MissouriMRDT/ScienceHeaterElement_Breakout/README.md

# ScienceHeater_2024
Files for Science Heater
