MissouriMRDT/ScienceHeaterElement_Breakout/Hardware/ScienceHeaterElement_2023.kicad_pcb

## KiCad design Hardware/ScienceHeaterElement_2023.kicad_pcb (2023-11-14)

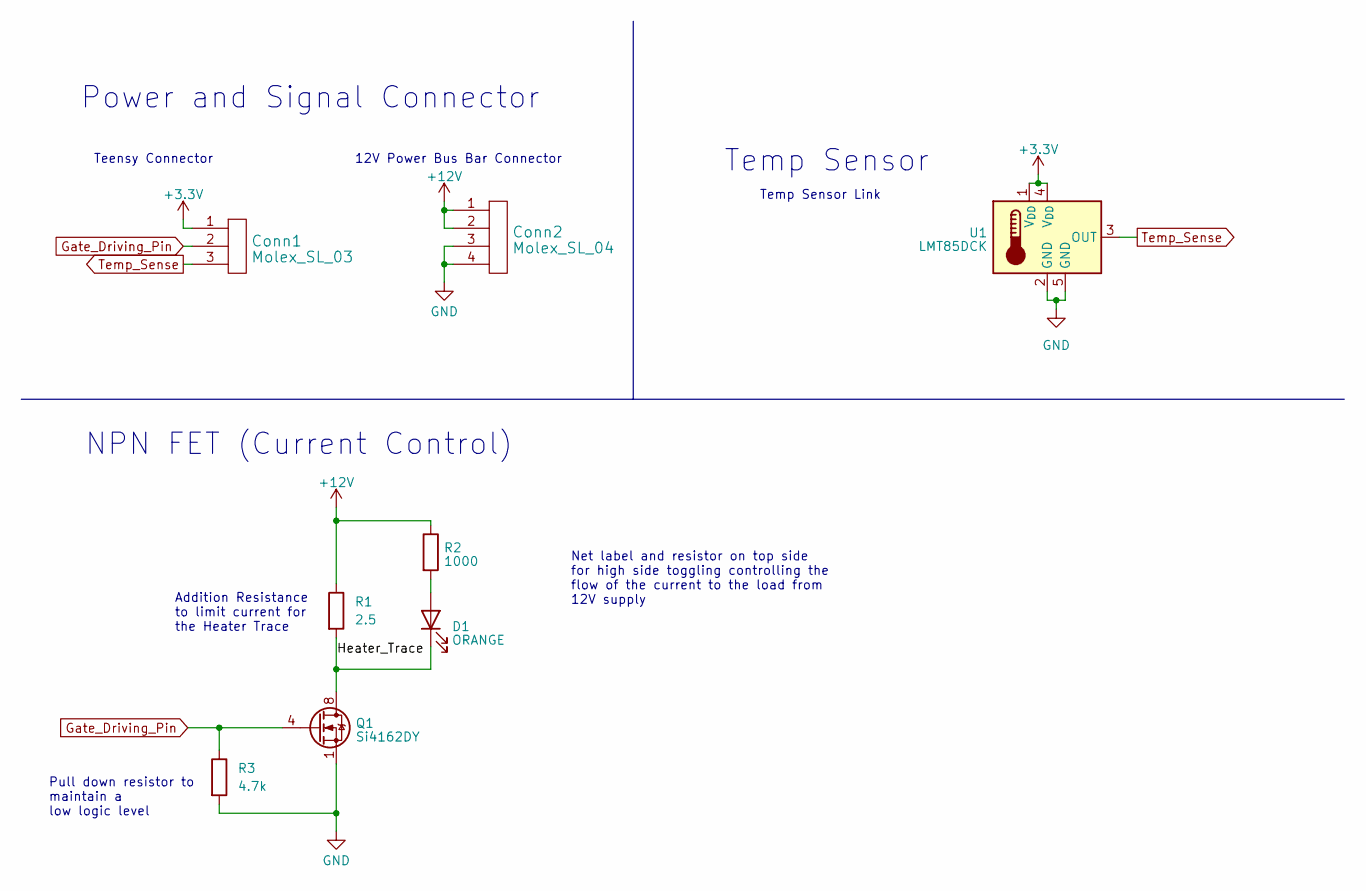
[picture p1: schematic ScienceHeaterElement_2023.kicad_sch]

Parts:
Conn1: Molex_SL_03; MOLEX_SL_03_Horizontal
Conn2: Molex_SL_04; MOLEX_SL_04_Horizontal
D1: ORANGE; LED_0603_1608Metric_Pad1.05x0.95mm_HandSolder
Q1: Si4162DY; SOIC-8_3.9x4.9mm_P1.27mm
R1: 2.5; TO-220-2_Horizontal_TabDown
R2: 1000; R_0603_1608Metric_Pad0.98x0.95mm_HandSolder
R3: 4.7k; R_0603_1608Metric_Pad0.98x0.95mm_HandSolder
U1: LMT85DCK; SOT-353_SC-70-5

Connections:
+3.3V: Conn1.1, U1.1 (V_{DD}), U1.4 (V_{DD})
+12V: Conn2.1, Conn2.2, R1.1, R2.1
/Heater_Trace: D1.1 (K), Q1.5 (D), Q1.6 (D), Q1.7 (D), Q1.8 (D), R1.2
GND: Conn2.3, Conn2.4, Q1.1 (S), Q1.2 (S), Q1.3 (S), R3.2, U1.2 (GND), U1.5 (GND)
Gate_Driving_Pin: Conn1.2, Q1.4 (G), R3.1
unnamed: D1.2 (A), R2.2
Temp_Sense: Conn1.3, U1.3 (OUT)

Notes on the sheet:
Addition Resistance to limit current for the Heater Trace
12V Power Bus Bar Connector
Net label and resistor on top side for high side toggling controlling the flow of the current to the load from 12V supply
Temp Sensor Link
Teensy Connector
Power and Signal Connector
NPN FET (Current Control)
Temp Sensor
Pull down resistor to maintain a low logic level

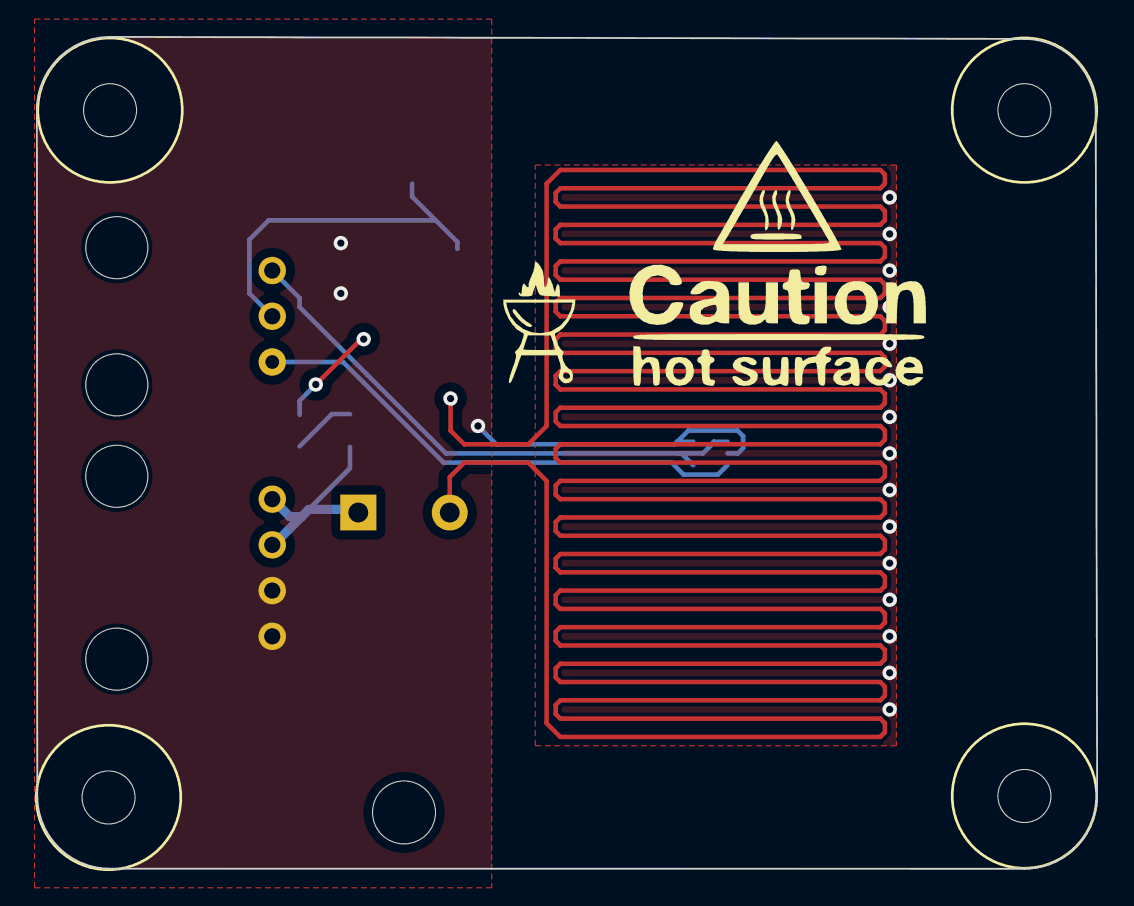
[picture p2: board ScienceHeaterElement_2023.kicad_pcb from above]

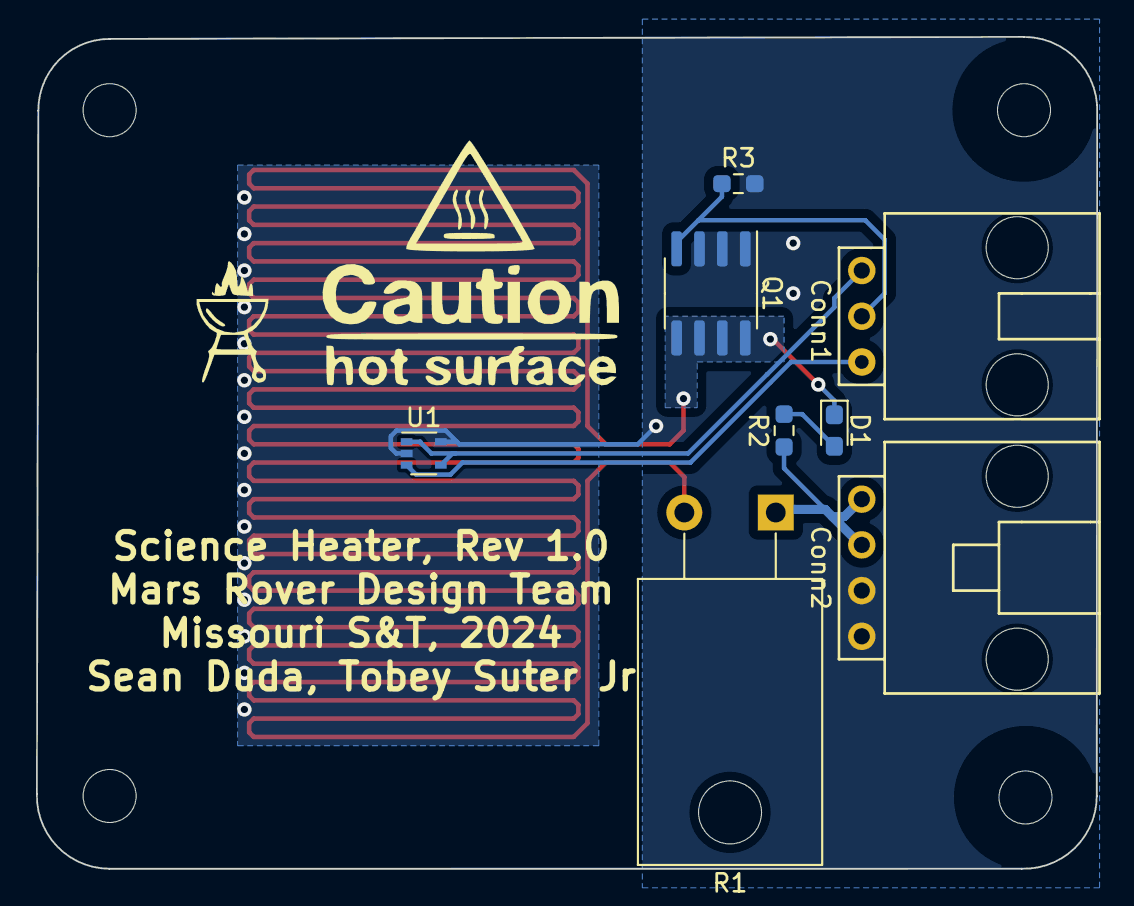
[picture p3: board ScienceHeaterElement_2023.kicad_pcb from below]

Board: 2 copper layers, 58.9 x 46.2 mm, 8 parts (8 on the bottom side), 7 nets.
