MissouriMRDT/ScienceHeaterElement_Breakout/(commit log)

2023-09-14 Add files via upload
    Here is the initial design for Science Heater
    [ScienceHeaterElement_2023.kicad_pcb, ScienceHeaterElement_2023.kicad_sch]
2023-09-14 Science Heater KiCad
    Inserted Anderson components, a temperature sensor and a molex SL.
    [ScienceHeaterElement_2023.kicad_sch]
2023-09-24 Added BJT Circuit
    Created BJT emitter bias circuit
    [ScienceHeaterElement_2023.kicad_pcb, ScienceHeaterElement_2023.kicad_sch]
2023-09-24 PDR
    Changed BJT circuit
    [ScienceHeaterElement_2023.kicad_sch]
2023-09-28 Added LEDs and Resistor values
    Added LEDs and Resistor values
    [ScienceHeaterElement_2023.kicad_sch]
2023-09-30 Changed LED power and Molex 7 pin
    Changed LED power from two 12V to a 12V and a 3.3V to indicate power of the two lines, and changed the molex 7 pin connector to a 3 pin and a 4 pin
    [ScienceHeaterElement_2023.csv, ScienceHeaterElement_2023.kicad_sch]
2023-10-06 Switched BJT to MOSFET
    Switched to a MOSFET from a BJT. The testing for the BJT gave us unusable results for controlling the current flow through the BJT so we switched to a MOSFET which allows easier controls of the heating element
    [ScienceHeaterElement_2023.kicad_sch]
2023-10-11 Changed MOSFET Circuit to High Side toggle
    Changed MOSFET Circuit to High Side toggling circuit to allow for proper control from the teensy
    [ScienceHeaterElement_2023.kicad_sch]
2023-10-15 Created PCB traces
    Created PCB traces for Science Heater with components placed
    [ScienceHeaterElement_2023.kicad_pcb, ScienceHeaterElement_2023.kicad_sch]
2023-10-16 Updated KiCad files and adjusted schematic to meet new requirements
    Updated KiCad files and adjusted schematic to meet new requirements such as an LED in series to indicate Heater trace power
    [ScienceHeaterElement_2023.csv, ScienceHeaterElement_2023.kicad_pcb, ScienceHeaterElement_2023.kicad_sch]
2023-10-16 Updated save from last push
    Updated save issue from last push. This has all the necessary schematic changes
    [ScienceHeaterElement_2023.kicad_sch]
2023-10-19 Schematic Rework
    Moved all devices to the back side of the board. Compressed the board down to a smaller area. Added heat traces and created a keep out area.
    [ScienceHeaterElement_2023.kicad_pcb]
2023-10-23 Fixed edge cuts and ground plane
    Fixed edge cuts to rounded edges and created one ground plane and then filled the area.
    [ScienceHeaterElement_2023.kicad_pcb, ScienceHeaterElement_2023.kicad_sch]
2023-11-02 Updated Silkscreen
    Updated silkscreen with warning symbols
    [ScienceHeaterElement_2023.kicad_pcb]
2023-11-02 Edited heater traces and blockout area
    Increased the blockout area to a .75 by .75 and edited the heater traces to fit the new area. Added text to label the board. Moved temp sensor closer to the heater traces.
    [ScienceHeaterElement_2023.kicad_pcb]
2023-11-02 Changed overall size and heating trace area
    Changed size and heating trace area to more effectively heat the microfluidic chips
    [ScienceHeaterElement_2023.kicad_pcb]
2023-11-05 Completed Changes
    Completed final changes such as trace work, flipped components, changed gnd keep out
    [ScienceHeaterElement_2023.kicad_pcb]
2023-11-06 Updated layout for order
    [ScienceHeaterElement_2023.kicad_pcb, ScienceHeaterElement_2023.kicad_sch]
2023-11-06 Generated Gerbs
    [ScienceHeaterElement_2023-B_Cu.gbr, ScienceHeaterElement_2023-B_Mask.gbr, ScienceHeaterElement_2023-B_Paste.gbr, ScienceHeaterElement_2023-B_Silkscreen.gbr, ScienceHeaterElement_2023-Edge_Cuts.gbr, ScienceHeaterElement_2023-F_Cu.gbr, ScienceHeaterElement_2023-F_Mask.gbr, ScienceHeaterElement_2023-F_Paste.gbr]
2023-11-06 Add back mounting holes and regenerate Gerbs
    [ScienceHeaterElement_2023-B_Cu.gbr, ScienceHeaterElement_2023-B_Mask.gbr, ScienceHeaterElement_2023-B_Paste.gbr, ScienceHeaterElement_2023-B_Silkscreen.gbr, ScienceHeaterElement_2023-Edge_Cuts.gbr, ScienceHeaterElement_2023-F_Cu.gbr, ScienceHeaterElement_2023-F_Mask.gbr, ScienceHeaterElement_2023-F_Paste.gbr]
2023-11-07 Changed Temp Sensor plane to GND
    Changed Temp sensor plane to GND and added GND vias between front and back layers
    [ScienceHeaterElement_2023.kicad_pcb]
2023-11-08 Expanded GND plane past heater trace area
    Extended GND plane past heater trace area and fixed GND island by connecting GND of temp sensor to GND plane properly
    [ScienceHeaterElement_2023.kicad_pcb]
2023-11-09 Replaced current limiting resistor
    Replaced current limiting resistor with 2.5 Ohm resistor and changed the resistor package
    [ScienceHeaterElement_2023.kicad_pcb, ScienceHeaterElement_2023.kicad_sch]
2023-11-09 Moved silkscreen labels
    Moved silkscreen labels to where they can be seen properly
    [ScienceHeaterElement_2023.kicad_pcb]
2023-11-14 Generated Gerber Files
    Generated Gerber Files to send to JLCPCB
    [ScienceHeaterElement_2023-B_Cu.gbr, ScienceHeaterElement_2023-B_Mask.gbr, ScienceHeaterElement_2023-B_Paste.gbr, ScienceHeaterElement_2023-B_Silkscreen.gbr, ScienceHeaterElement_2023-Edge_Cuts.gbr, ScienceHeaterElement_2023-F_Cu.gbr, ScienceHeaterElement_2023-F_Mask.gbr, ScienceHeaterElement_2023-F_Paste.gbr]
